pmaroti/RP2040_websdr/mixer_lpf4/plots/results.txt

== LM358 model vs datasheet (one amplifier, 9 V supply) ==
DC open-loop gain      99.9 dB    datasheet 100 dB typ
unity-gain frequency   0.70 MHz   datasheet 0.7 MHz (TI)
slew rate              0.30 V/us  datasheet 0.3 V/us
output swing            5 mV .. 7.50 V   datasheet ~5 mV .. Vcc-1.5 V

== Filters alone (drain -> filter output, incl. bias network) ==
                          4th-order Cheb.  Sallen-Key   simple RC
gain at 1 kHz                  -0.1 dB        -0.2 dB        -1.9 dB   
variation 0.1..8 kHz            0.8 dB         6.8 dB         5.1 dB   (max - min)
-3 dB frequency                8.8 kHz        5.8 kHz        5.5 kHz   
at 8 kHz (top of IF)            0.0 dB        -7.1 dB        -6.8 dB   
at 12.5 kHz (Nyquist)         -20.1 dB       -14.4 dB        -9.8 dB   
at 17 kHz (-> 8 kHz)          -32.9 dB       -20.0 dB       -12.2 dB   
at 20 kHz (-> 5 kHz)          -39.3 dB       -23.1 dB       -13.5 dB   
at 25 kHz (-> 0 Hz)           -47.7 dB       -27.5 dB       -15.3 dB   
at 7.1 MHz (LO)              -137.6 dB       -98.6 dB       -64.2 dB   

== Tolerance check, 200 random builds each (resistors 1 %) ==
capacitors 5 %: ripple 0.1..8 kHz median 0.86 dB, worst 1.89 dB; at 8 kHz -0.7 ... 0.9 dB; at 17 kHz -34.1 ... -31.4 dB
capacitors 2 %: ripple 0.1..8 kHz median 0.83 dB, worst 1.29 dB; at 8 kHz -0.3 ... 0.6 dB; at 17 kHz -33.4 ... -32.1 dB

== Operating point, LO running (50 % duty) ==
V(source) avg         0.517 V  -> I avg = 2.35 mA
V(drain)  avg         6.651 V

== Mixer, LO 7.100 MHz, RF 7.103000 MHz @ 10 mV pk ==
IF 3 kHz at ADC pin     25.83 mV pk
conversion gain RF->ADC    8.2 dB   (simple RC: 5.1 dB, Sallen-Key: 7.6 dB)
ADC pin DC / min / max 1.641 / 1.604 / 1.669 V
LO ripple at ADC pin    0.009 mV pp (approx; simple RC: 1.03, Sallen-Key: 0.023 mV pp)

== Conversion gain vs IF frequency (RF->ADC pin) ==
IF   0.3 kHz      7.4 dB
IF   1.0 kHz      7.7 dB
IF   3.0 kHz      8.3 dB
IF   5.0 kHz      8.0 dB
IF   7.0 kHz      8.5 dB
IF   8.0 kHz      8.0 dB
IF   9.0 kHz      4.1 dB
IF  10.0 kHz     -1.4 dB
IF  12.5 kHz    -12.2 dB
IF  15.0 kHz    -20.1 dB   -> aliases to 10.0 kHz
IF  17.0 kHz    -24.4 dB   -> aliases to 8.0 kHz
IF  20.0 kHz    -31.6 dB   -> aliases to 5.0 kHz
IF  25.0 kHz    -40.2 dB   -> aliases to 0.0 kHz

== Large RF input: ADC pin stays inside 0..3.3 V ==
RF     1.0 mV pk -> IF     2.3 mV pk, ADC min 1.629 V max 1.636 V
RF    10.0 mV pk -> IF    25.7 mV pk, ADC min 1.605 V max 1.659 V
RF    30.0 mV pk -> IF    77.7 mV pk, ADC min 1.552 V max 1.711 V
RF   100.0 mV pk -> IF   259.1 mV pk, ADC min 1.361 V max 1.883 V
RF   300.0 mV pk -> IF   772.0 mV pk, ADC min 0.759 V max 2.320 V
RF  1000.0 mV pk -> IF  1461.9 mV pk, ADC min 0.005 V max 3.462 V

== Power-up (both rails 0 -> on in 1 ms, caps discharged) ==
LM358 output max 6.097 V, ADC pin max 3.560 V, min 0.004 V, at 400 ms 1.651 V

== 5 V supply (mixer + LM358 on 5 V, R3 = 470 ohm) ==
V(source) 0.669 V (I = 1.42 mA), V(drain) 3.576 V
conversion gain RF->ADC at 3 kHz    6.6 dB   (9 V: 8.2 dB)
