pmaroti/RP2040_websdr/Result_5M_LO_5000.98K_RF.jpg

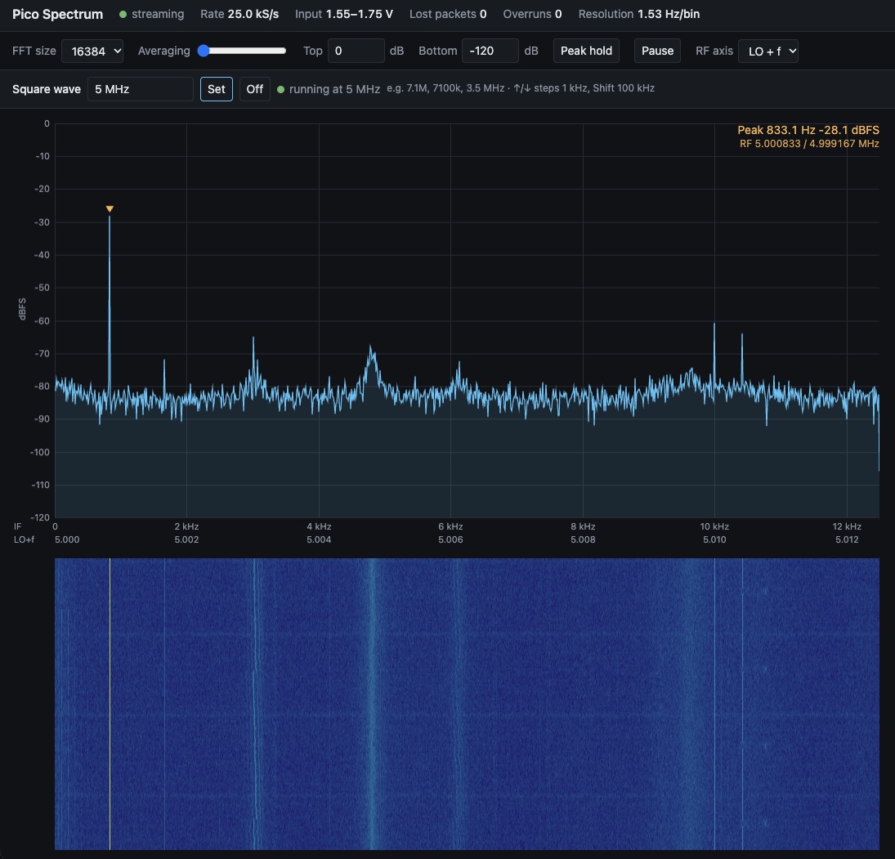
Result_5M_LO_5000.98K_RF.jpg
